tommag/massue_bento_v2/README.md

massue_bento_v2
===============

KiCad PCB for Bento juggling club
