tommag/massue_bento_v2/massue_bento_v2_bottom.png

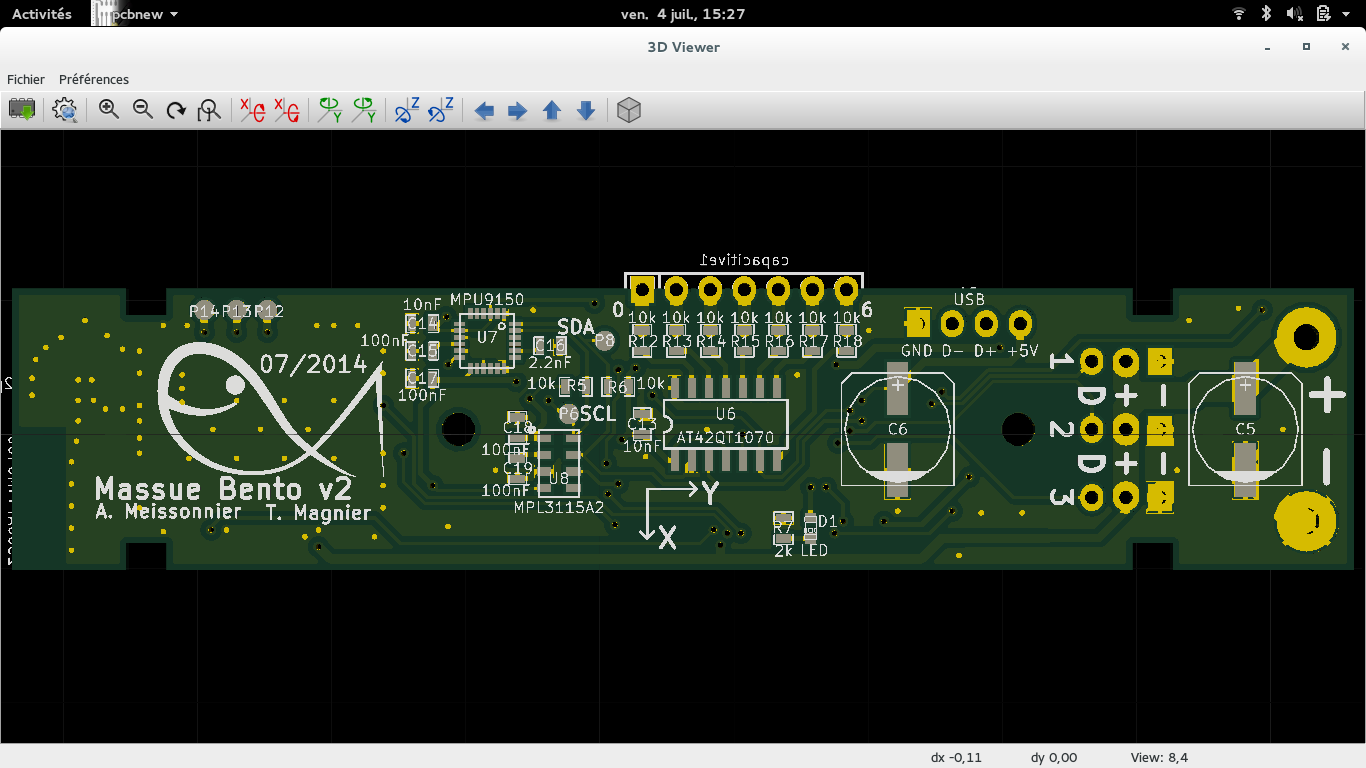
massue_bento_v2_bottom.png
