tommag/massue_bento_v2/massue_bento_v2_dimensions.png

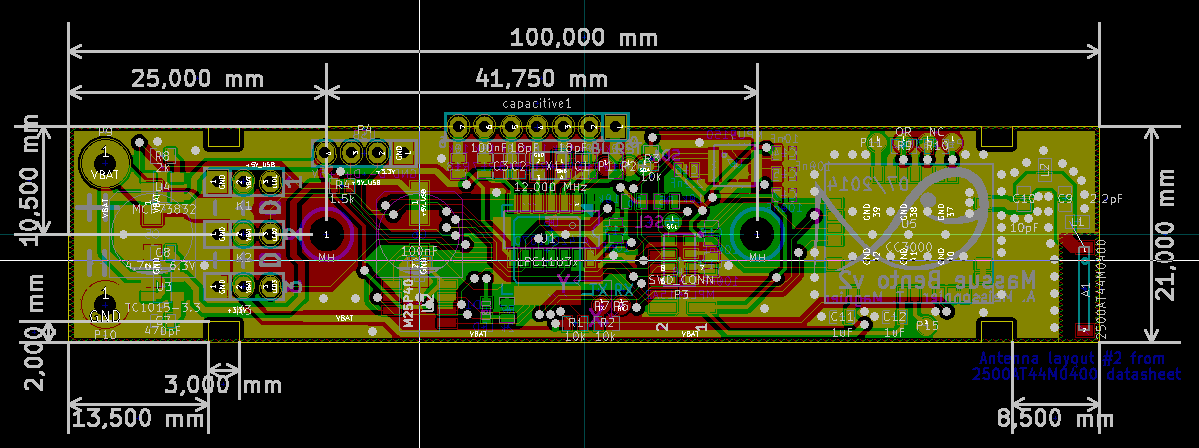
massue_bento_v2_dimensions.png
