tommag/massue_bento_v2/massue_bento_v2_top.png

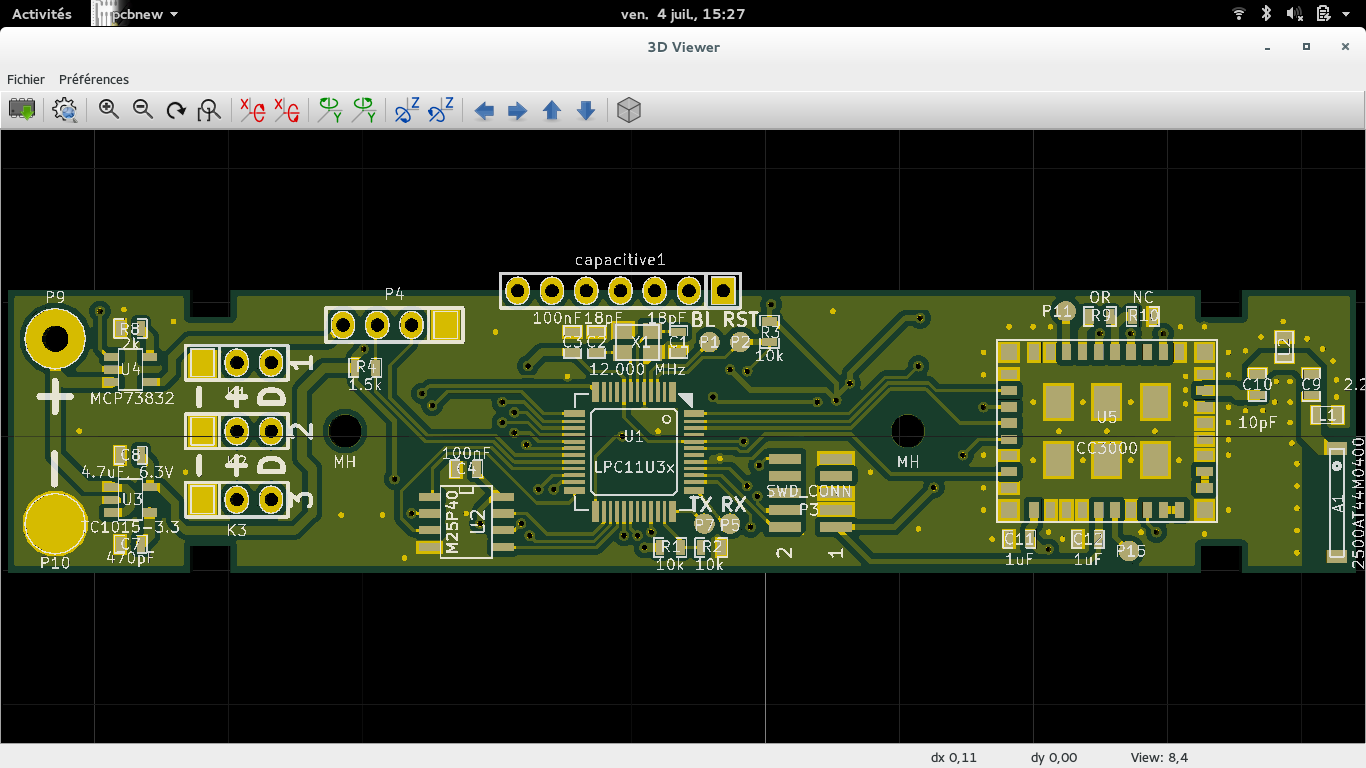
massue_bento_v2_top.png
