tommag/massue_bento_v2/massue_bento_v2.kicad_pcb

## KiCad design massue_bento_v2.kicad_pcb (2014-07-04)

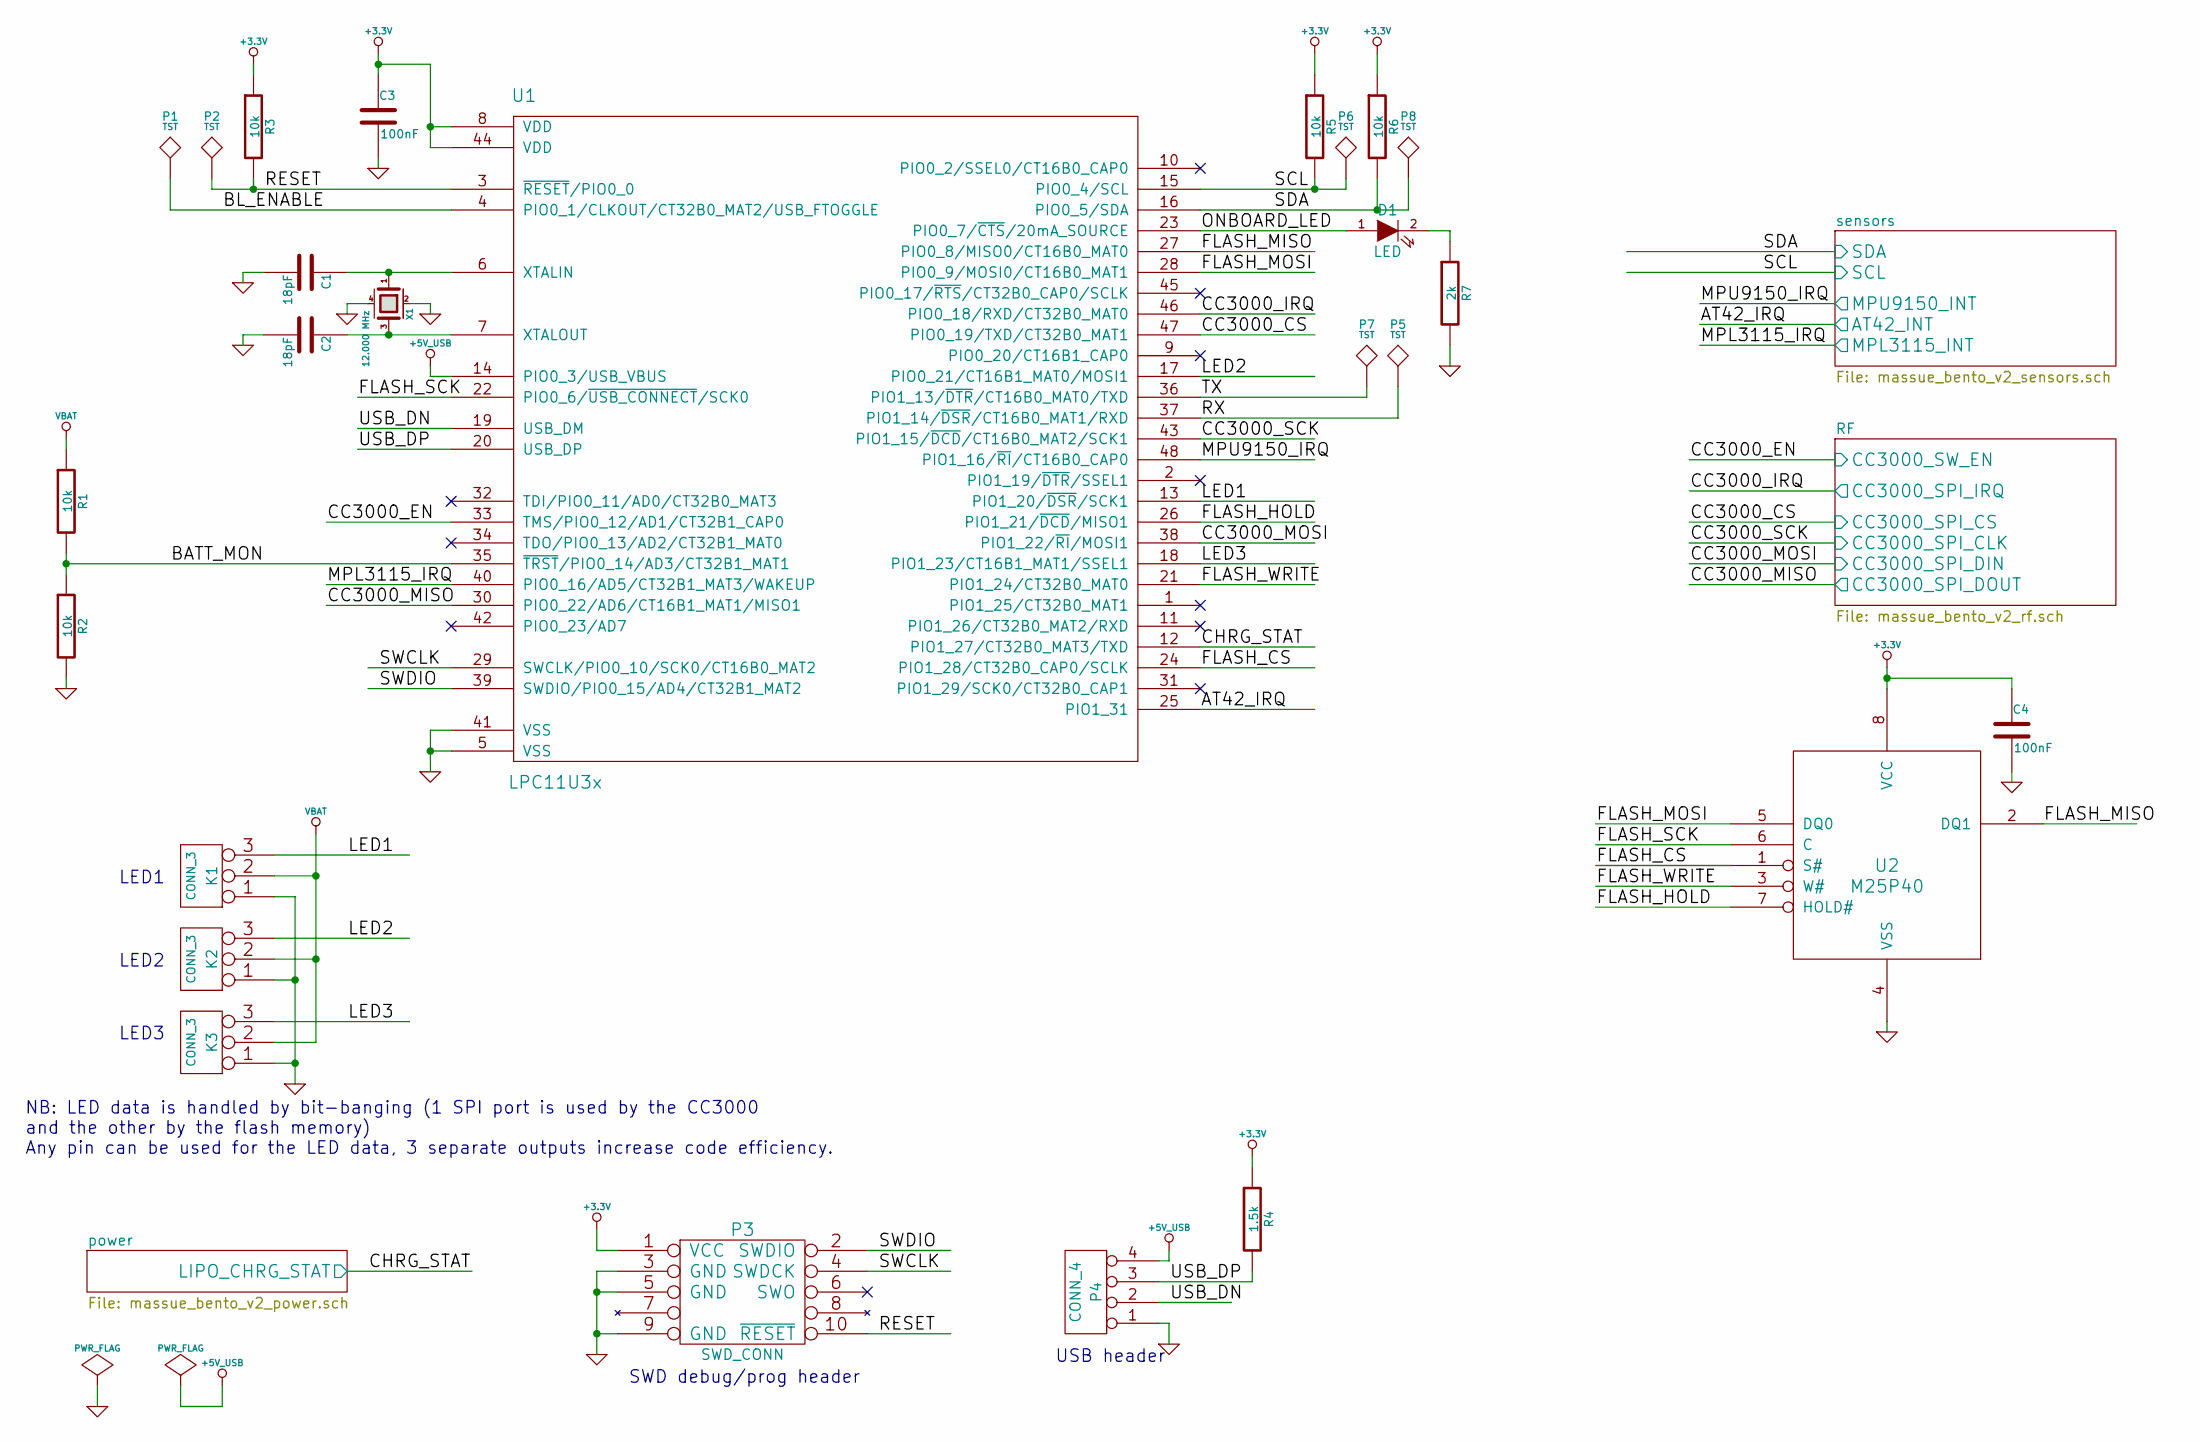
[picture p4: schematic massue_bento_v2.sch, Massue Bento]

Parts:
C1, C2: 18pF
C3, C4: 100nF
D1: LED
K1, K2, K3: CONN_3
P1, P2, P5, P6, P7, P8: TST
P3: SWD_CONN
P4: CONN_4
R1, R2, R3, R5, R6: 10k
R4: 1.5k
R7: 2k
U1: LPC11U3x
U2: M25P40
X1: 12.000 MHz

Connections:
+3.3V: C3.1, C4.1, P3.1 (VCC), R3.1, R4.1, R5.1, R6.1, U1.8 (VDD), U1.44 (VDD), U2.8 (VCC); also elsewhere on the board
+5V_USB: P4.4, U1.14 (PIO0_3/USB_VBUS); also elsewhere on the board
/BATT_MON: R1.2, R2.1, U1.35 (~TRST~/PIO0_14/AD3/CT32B1_MAT1)
/BL_ENABLE: P1.1, U1.4 (PIO0_1/CLKOUT/CT32B0_MAT2/USB_FTOGGLE)
/FLASH_CS: U1.24 (PIO1_28/CT32B0_CAP0/SCLK), U2.1 (S#)
/FLASH_HOLD: U1.26 (PIO1_21/~DCD~/MISO1), U2.7 (HOLD#)
/FLASH_MISO: U1.27 (PIO0_8/MISO0/CT16B0_MAT0), U2.2 (DQ1)
/FLASH_MOSI: U1.28 (PIO0_9/MOSI0/CT16B0_MAT1), U2.5 (DQ0)
/FLASH_SCK: U1.22 (PIO0_6/~USB_CONNECT~/SCK0), U2.6 (C)
/FLASH_WRITE: U1.21 (PIO1_24/CT32B0_MAT0), U2.3 (W#)
/LED1: K1.3, U1.13 (PIO1_20/~DSR~/SCK1)
/LED2: K2.3, U1.17 (PIO0_21/CT16B1_MAT0/MOSI1)
/LED3: K3.3, U1.18 (PIO1_23/CT16B1_MAT1/SSEL1)
/ONBOARD_LED: D1.1 (A), U1.23 (PIO0_7/~CTS~/20mA_SOURCE)
/RESET: P2.1, P3.10 (~RESET), R3.2, U1.3 (~RESET~/PIO0_0)
/RF/CC3000_SPI_CLK: U1.43 (PIO1_15/~DCD~/CT16B0_MAT2/SCK1); also elsewhere on the board
/RF/CC3000_SPI_CS: U1.47 (PIO0_19/TXD/CT32B0_MAT1); also elsewhere on the board
/RF/CC3000_SPI_DIN: U1.38 (PIO1_22/~RI~/MOSI1); also elsewhere on the board
/RF/CC3000_SPI_DOUT: U1.30 (PIO0_22/AD6/CT16B1_MAT1/MISO1); also elsewhere on the board
/RF/CC3000_SPI_IRQ: U1.46 (PIO0_18/RXD/CT32B0_MAT0); also elsewhere on the board
/RF/CC3000_SW_EN: U1.33 (TMS/PIO0_12/AD1/CT32B1_CAP0); also elsewhere on the board
/RX: P5.1, U1.37 (PIO1_14/~DSR~/CT16B0_MAT1/RXD)
/SWCLK: P3.4 (SWDCK), U1.29 (SWCLK/PIO0_10/SCK0/CT16B0_MAT2)
/SWDIO: P3.2 (SWDIO), U1.39 (SWDIO/PIO0_15/AD4/CT32B1_MAT2)
/TX: P7.1, U1.36 (PIO1_13/~DTR~/CT16B0_MAT0/TXD)
/USB_DN: P4.2, U1.19 (USB_DM)
/USB_DP: P4.3, R4.2, U1.20 (USB_DP)
/power/LIPO_CHRG_STAT: U1.12 (PIO1_27/CT32B0_MAT3/TXD); also elsewhere on the board
/sensors/AT42_INT: U1.25 (PIO1_31); also elsewhere on the board
/sensors/MPL3115_INT: U1.40 (PIO0_16/AD5/CT32B1_MAT3/WAKEUP); also elsewhere on the board
/sensors/MPU9150_INT: U1.48 (PIO1_16/~RI~/CT16B0_CAP0); also elsewhere on the board
/sensors/SCL: P6.1, R5.2, U1.15 (PIO0_4/SCL); also elsewhere on the board
/sensors/SDA: P8.1, R6.2, U1.16 (PIO0_5/SDA); also elsewhere on the board
GND: C1.2, C2.2, C3.2, C4.2, K1.1, K2.1, K3.1, P3.3 (GND), P3.5 (GND), P3.9 (GND), P4.1, R2.2, R7.2, U1.5 (VSS), U1.41 (VSS), U2.4 (VSS), X1.2 (GND), X1.4 (GND); also elsewhere on the board
unnamed: C1.1, U1.6 (XTALIN), X1.1
unnamed: C2.1, U1.7 (XTALOUT), X1.3
unnamed: D1.2 (K), R7.1
VBAT: K1.2 (PM), K2.2 (PM), K3.2 (PM), R1.1; also elsewhere on the board

Notes on the sheet:
USB header
SWD debug/prog header
LED1
LED2
LED3
NB: LED data is handled by bit-banging (1 SPI port is used by the CC3000 and the other by the flash memory) Any pin can be used for the LED data, 3 separate outputs increase code efficiency.

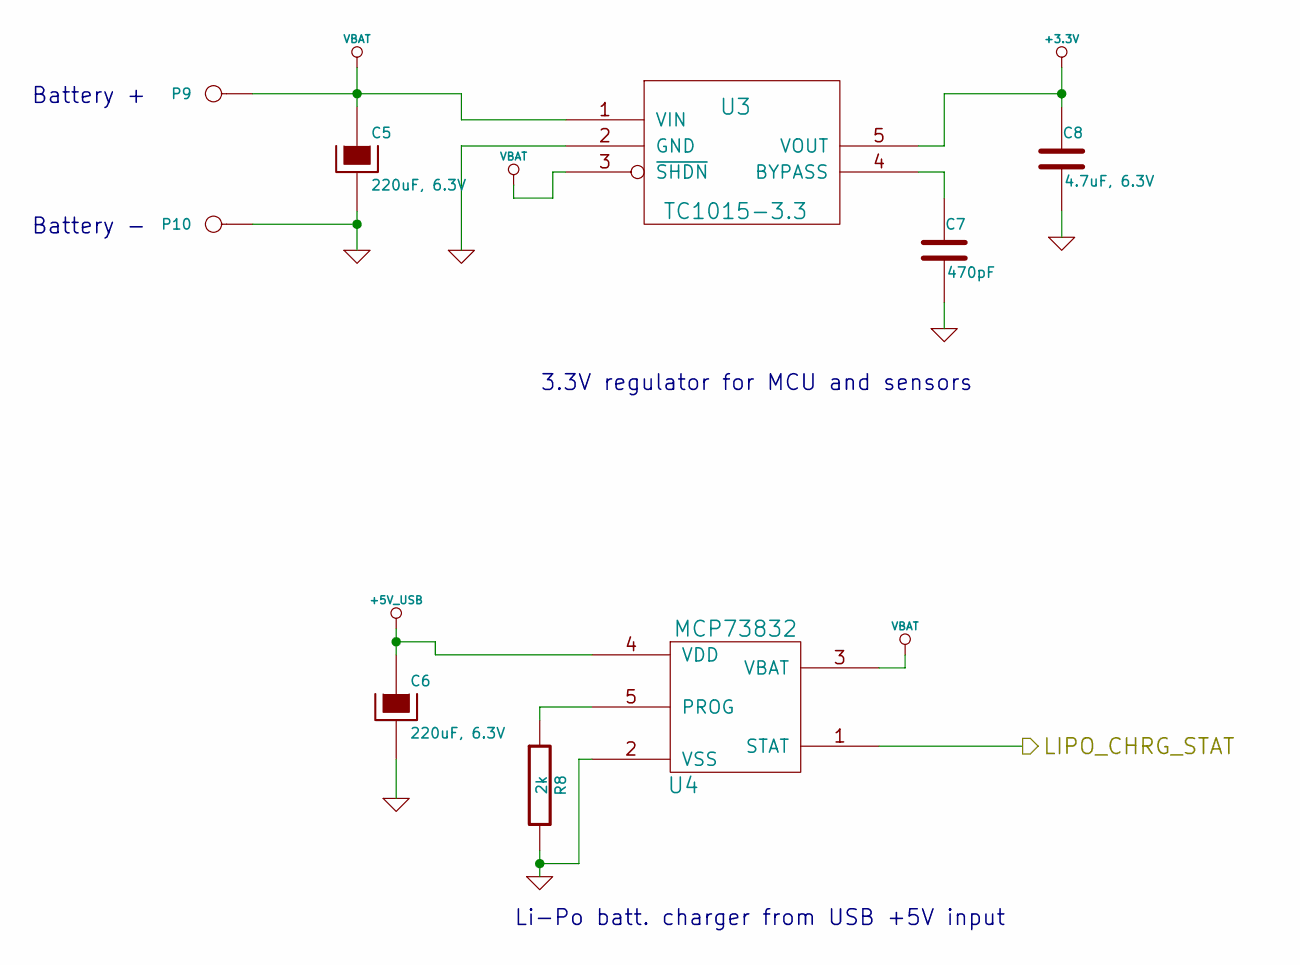
[picture p5: schematic massue_bento_v2_power.sch]

Parts:
C5, C6: 220uF, 6.3V
C7: 470pF
C8: 4.7uF, 6.3V
P9, P10: CONN_1
R8: 2k
U3: TC1015-3.3
U4: MCP73832

Connections:
+3.3V: C8.1, U3.5 (VOUT); also elsewhere on the board
+5V_USB: C6.1, U4.4 (VDD); also elsewhere on the board
/power/LIPO_CHRG_STAT: U4.1 (STAT); also elsewhere on the board
GND: C5.2, C6.2, C7.2, C8.2, P10.1, R8.2, U3.2 (GND), U4.2 (VSS); also elsewhere on the board
unnamed: C7.1, U3.4 (BYPASS)
unnamed: R8.1, U4.5 (PROG)
VBAT: C5.1, P9.1, U3.1 (VIN), U3.3 (~SHDN), U4.3 (VBAT); also elsewhere on the board

Notes on the sheet:
Battery +
Battery -
3.3V regulator for MCU and sensors
Li-Po batt. charger from USB +5V input

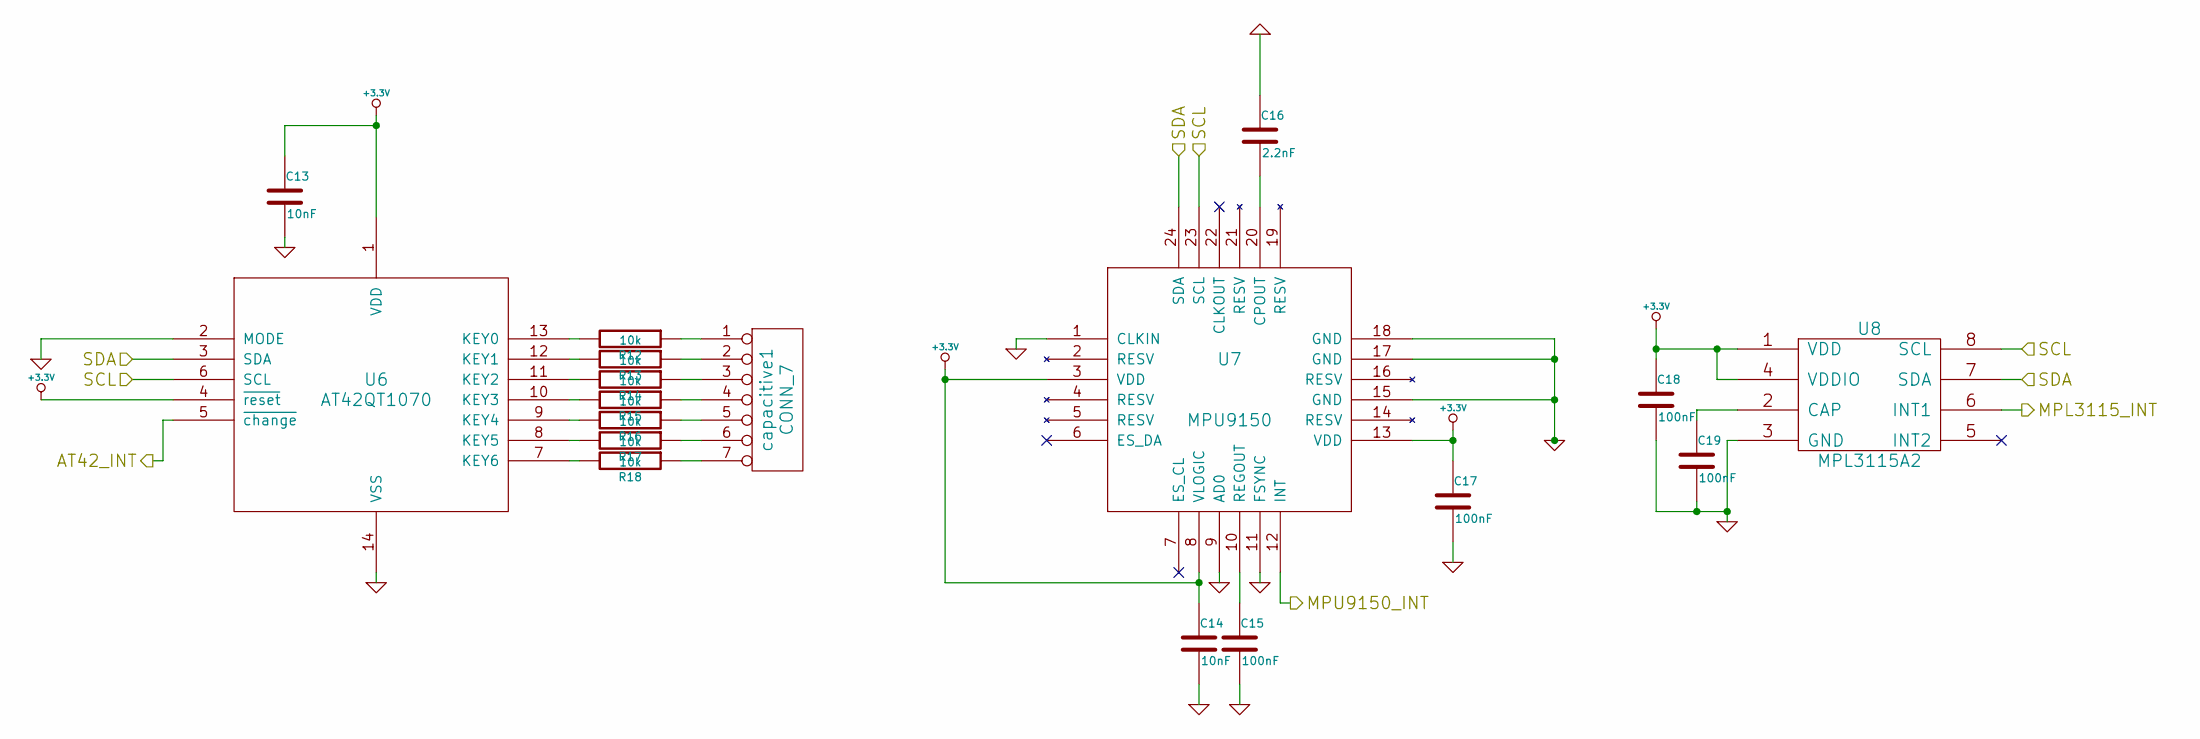
[picture p6: schematic massue_bento_v2_sensors.sch]

Parts:
C13, C14: 10nF
C15, C17, C18, C19: 100nF
C16: 2.2nF
R12, R13, R14, R15, R16, R17, R18: 10k
U6: AT42QT1070
U7: MPU9150
U8: MPL3115A2
capacitive1: CONN_7

Connections:
+3.3V: C13.1, C14.1, C17.1, C18.1, U6.1 (VDD), U6.4 (~reset), U7.3 (VDD), U7.8 (VLOGIC), U7.13 (VDD), U8.1 (VDD), U8.4 (VDDIO); also elsewhere on the board
/sensors/AT42_INT: U6.5 (~change); also elsewhere on the board
/sensors/MPL3115_INT: U8.6 (INT1); also elsewhere on the board
/sensors/MPU9150_INT: U7.12 (INT); also elsewhere on the board
/sensors/SCL: U6.6 (SCL), U7.23 (SCL), U8.8 (SCL); also elsewhere on the board
/sensors/SDA: U6.3 (SDA), U7.24 (SDA), U8.7 (SDA); also elsewhere on the board
GND: C13.2, C14.2, C15.2, C16.1, C17.2, C18.2, C19.2, U6.2 (MODE), U6.14 (VSS), U7.1 (CLKIN), U7.9 (AD0), U7.11 (FSYNC), U7.15 (GND), U7.17 (GND), U7.18 (GND), U8.3 (GND); also elsewhere on the board
unnamed: C15.1, U7.10 (REGOUT)
unnamed: C16.2, U7.20 (CPOUT)
unnamed: C19.1, U8.2 (CAP)
unnamed: R12.1, capacitive1.1
unnamed: R12.2, U6.13 (KEY0)
unnamed: R13.1, capacitive1.2
unnamed: R13.2, U6.12 (KEY1)
unnamed: R14.1, capacitive1.3
unnamed: R14.2, U6.11 (KEY2)
unnamed: R15.1, capacitive1.4
unnamed: R15.2, U6.10 (KEY3)
unnamed: R16.1, capacitive1.5
unnamed: R16.2, U6.9 (KEY4)
unnamed: R17.1, capacitive1.6
unnamed: R17.2, U6.8 (KEY5)
unnamed: R18.1, capacitive1.7
unnamed: R18.2, U6.7 (KEY6)

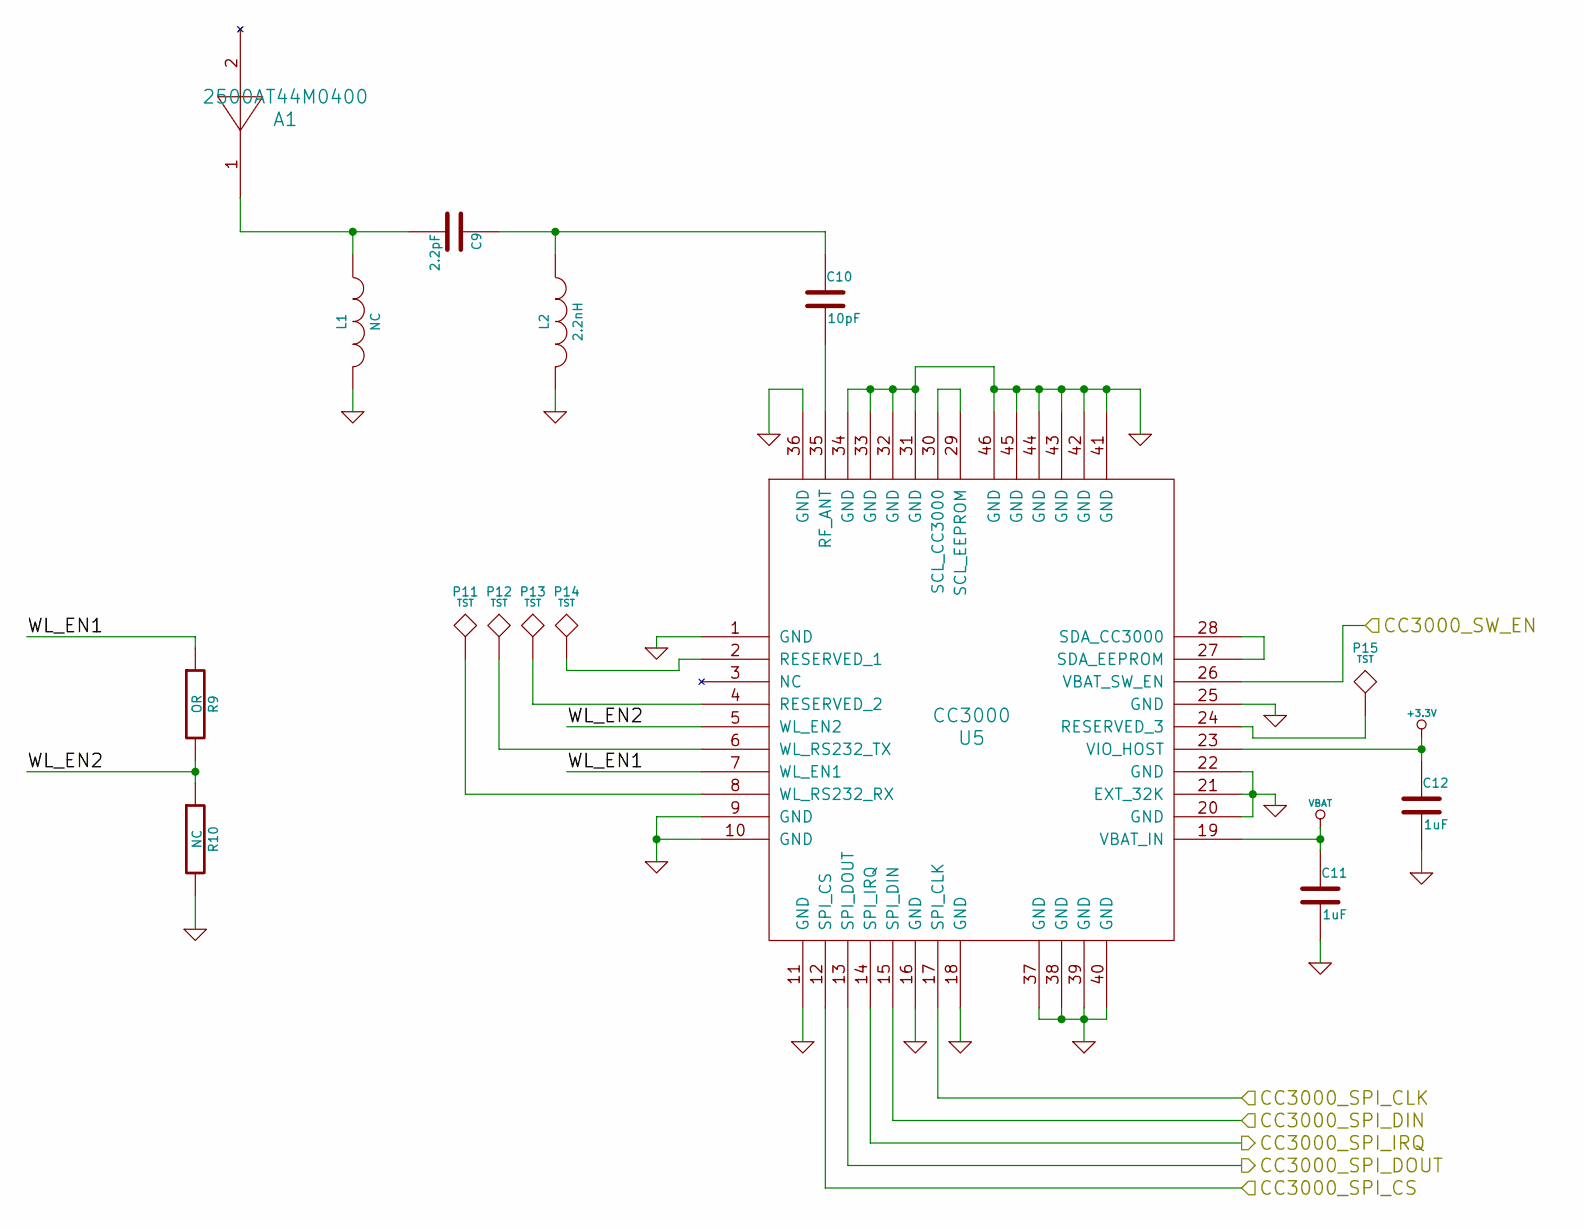
[picture p7: schematic massue_bento_v2_rf.sch]

Parts:
A1: 2500AT44M0400
C9: 2.2pF
C10: 10pF
C11, C12: 1uF
L1: NC
L2: 2.2nH
P11, P12, P13, P14, P15: TST
R9: OR
R10: NC
U5: CC3000

Connections:
+3.3V: C12.1, U5.23 (VIO_HOST); also elsewhere on the board
/RF/CC3000_SPI_CLK: U5.17 (SPI_CLK); also elsewhere on the board
/RF/CC3000_SPI_CS: U5.12 (SPI_CS); also elsewhere on the board
/RF/CC3000_SPI_DIN: U5.15 (SPI_DIN); also elsewhere on the board
/RF/CC3000_SPI_DOUT: U5.13 (SPI_DOUT); also elsewhere on the board
/RF/CC3000_SPI_IRQ: U5.14 (SPI_IRQ); also elsewhere on the board
/RF/CC3000_SW_EN: U5.26 (VBAT_SW_EN); also elsewhere on the board
/RF/WL_EN1: R9.1, U5.7 (WL_EN1)
/RF/WL_EN2: R9.2, R10.1, U5.5 (WL_EN2)
GND: C11.2, C12.2, L1.2, L2.2, R10.2, U5.1 (GND), U5.9 (GND), U5.10 (GND), U5.11 (GND), U5.16 (GND), U5.18 (GND), U5.20 (GND), U5.21 (EXT_32K), U5.22 (GND), U5.25 (GND), U5.31 (GND), U5.32 (GND), U5.33 (GND), U5.34 (GND), U5.36 (GND), U5.37 (GND), U5.38 (GND), U5.39 (GND), U5.40 (GND), U5.41 (GND), U5.42 (GND), U5.43 (GND), U5.44 (GND), U5.45 (GND), U5.46 (GND); also elsewhere on the board
unnamed: A1.1, C9.2, L1.1
unnamed: C9.1, C10.1, L2.1
unnamed: C10.2, U5.35 (RF_ANT)
unnamed: P11.1, U5.8 (WL_RS232_RX)
unnamed: P12.1, U5.6 (WL_RS232_TX)
unnamed: P13.1, U5.4 (RESERVED_2)
unnamed: P14.1, U5.2 (RESERVED_1)
unnamed: P15.1, U5.24 (RESERVED_3)
unnamed: U5.27 (SDA_EEPROM), U5.28 (SDA_CC3000)
unnamed: U5.29 (SCL_EEPROM), U5.30 (SCL_CC3000)
VBAT: C11.1, U5.19 (VBAT_IN); also elsewhere on the board

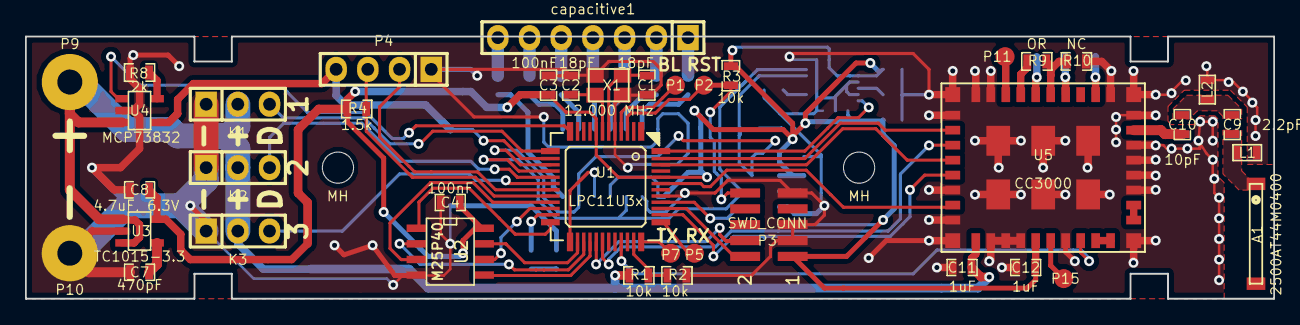
[picture p8: board massue_bento_v2.kicad_pcb from above]

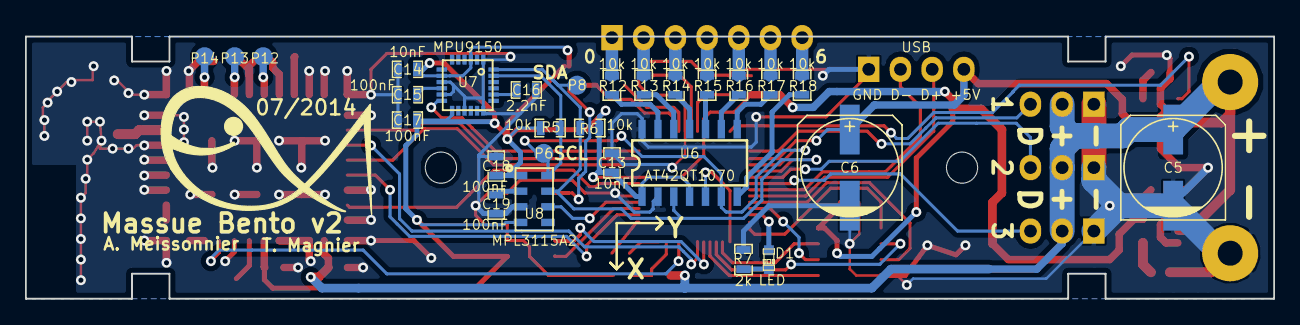
[picture p9: board massue_bento_v2.kicad_pcb from below]

Board: 2 copper layers, 100.0 x 21.0 mm, 70 parts (28 on the bottom side), 69 nets.

Other parts of the board:
MH: MountingHole_2-5mm_RevA_Date21Jun2010; MountingHole_2-5mm
MH#2: MountingHole_2-5mm_RevA_Date21Jun2010; MountingHole_2-5mm
