tommag/massue_bento_v2/(commit log)

2014-06-21 add empty schematic file
    [massue_bento_v2.sch]
2014-06-21 New : sub sheets creation for team working :)
    [massue_bento_v2.sch, massue_bento_v2_power.sch, massue_bento_v2_rf.sch, massue_bento_v2_sensors.sch]
2014-06-21 Add: RF / CC3000 schematic section based upon reference design
    [massue_bento_v2_rf.sch]
2014-06-21 Fix: use battery voltage to power CC3000
    [massue_bento_v2_rf.sch]
2014-06-21 Add: power management schematic section
    [massue_bento_v2_power.sch]
2014-06-21 Merge branch 'master' of https://github.com/tommag/massue_bento_v2
    Conflicts:
    massue_bento_v2_power.sch
    massue_bento_v2_rf.sch
    [massue_bento_v2.kicad_pcb, massue_bento_v2.sch, massue_bento_v2_power.sch, massue_bento_v2_rf.sch, massue_bento_v2_sensors.sch]
2014-06-21 New: main MCU connections and Flash memory
    [massue_bento_v2.sch, massue_bento_v2_power.sch, massue_bento_v2_rf.sch, massue_bento_v2_sensors.sch]
2014-06-22 New: end of the MCU connections, SPI ports connections, battery monitor circuit and LED headers
    [massue_bento_v2.sch, massue_bento_v2_power.sch, massue_bento_v2_rf.sch, massue_bento_v2_sensors.sch]
2014-06-22 Fix: global annotation, fixed bugs to satisfy ERC
    [massue_bento_v2.sch, massue_bento_v2_power.sch, massue_bento_v2_rf.sch, massue_bento_v2_sensors.sch]
2014-06-22 New : AT42 sensor
    [massue_bento_v2.sch, massue_bento_v2_power.sch, massue_bento_v2_rf.sch, massue_bento_v2_sensors.sch]
2014-06-22 Fix : pull up for I2C and AT42INT connection
    [massue_bento_v2.sch]
2014-06-25 New: association of footprints and components
    [massue_bento_v2.sch, massue_bento_v2_power.sch, massue_bento_v2_rf.sch, massue_bento_v2_sensors.sch]
2014-06-25 Clean: remove unnecessary pull-up resistor (integrated in MCU)
    [massue_bento_v2.sch, massue_bento_v2_sensors.sch]
2014-06-25 Clean: modified .gitignore to ignore PCB and lib backup files
2014-06-25 New: board outline and first raw component placement
    [massue_bento_v2.kicad_pcb]
2014-06-25 New: Setup design rules and trace widths
    [massue_bento_v2.kicad_pcb]
2014-06-26 Begin RF routing
    [massue_bento_v2.kicad_pcb]
2014-06-26 CC3000 and RF routing
    [massue_bento_v2.kicad_pcb]
2014-06-26 Fix: error in CC3000 component pinout
    [massue_bento_v2.kicad_pcb]
2014-06-27 New component placement
    [massue_bento_v2.kicad_pcb]
2014-06-27 New : Power routing
    [massue_bento_v2.kicad_pcb]
2014-06-28 Restore ground routing for CC3000
    [massue_bento_v2.kicad_pcb]
2014-06-28 Fix: LED strips are powered by VBAT and not 3.3V ; changed MCU pins to reflect component placement
    [massue_bento_v2.sch, massue_bento_v2_rf.sch, massue_bento_v2_sensors.sch]
2014-06-28 New: first routing for almost all signals
    [massue_bento_v2.kicad_pcb, massue_bento_v2.sch, massue_bento_v2_power.sch]
2014-06-29 Finished routing of signals, re-organization of power
    [massue_bento_v2.kicad_pcb, massue_bento_v2.sch]
2014-06-30 new : power ehencement
    [massue_bento_v2.kicad_pcb]
2014-07-01 New: first complete routing, no more unconnected nets
    [massue_bento_v2.kicad_pcb]
2014-07-03 Changed MS5607 altimeter for MPL3115A2
    [massue_bento_v2.kicad_pcb, massue_bento_v2.sch, massue_bento_v2_sensors.sch]
2014-07-03 Clean: additionnal ground vias, fixed USB differential signals length, add some labels
    [massue_bento_v2.kicad_pcb]
2014-07-03 Added version label and logo
    [massue_bento_v2.kicad_pcb]
2014-07-03 Add X/Y label for IMU axes
    [massue_bento_v2.kicad_pcb]
2014-07-04 Clean: same value for 100nF/0.1uf capacitors, re-organization of labels, add dimension labels
    [massue_bento_v2.kicad_pcb, massue_bento_v2.sch, massue_bento_v2_sensors.sch]
